PyroFourTwenty/SolarStation/3DModels/Sensorholder.stl

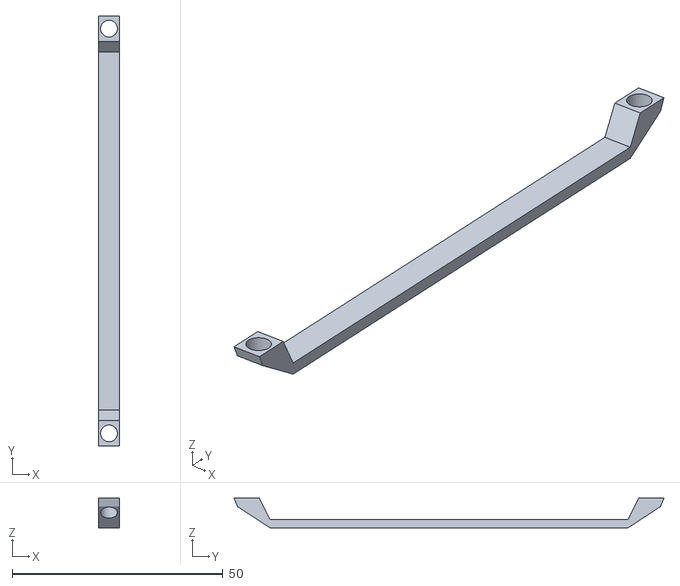
[picture p19: CAD file, 2020-07-06]
3DModels/Sensorholder.stl
5.00 x 102.0 x 7.00
