PyroFourTwenty/SolarStation/3DModels/RollerAngle.stl

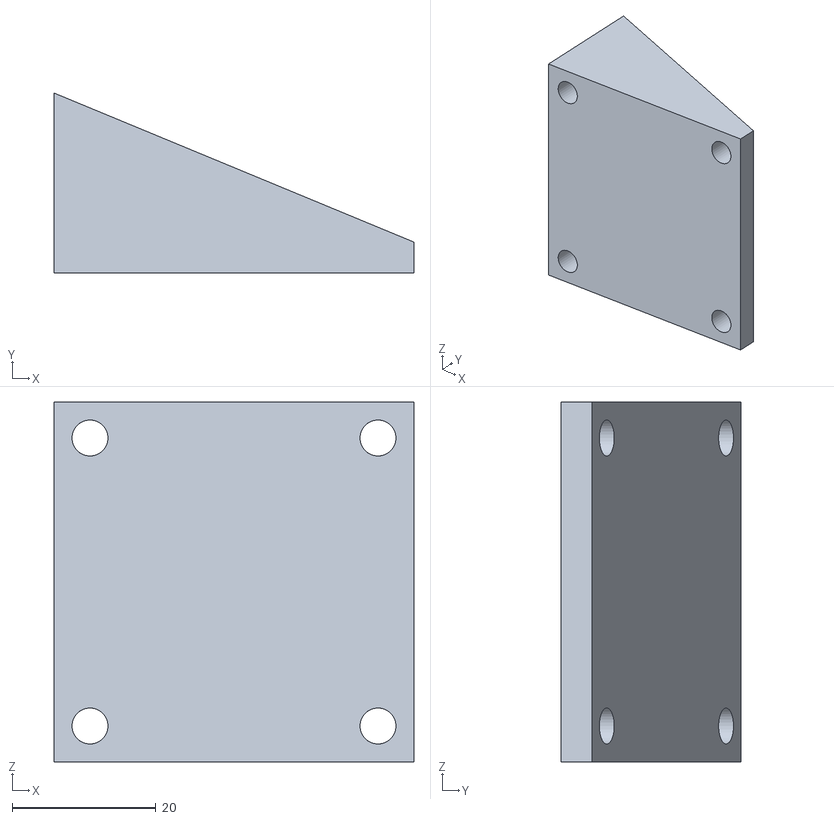
[picture p20: CAD file, 2020-07-06]
3DModels/RollerAngle.stl
50.0 x 25.0 x 50.0
