PyroFourTwenty/SolarStation/3DModels/MidAngle.stl

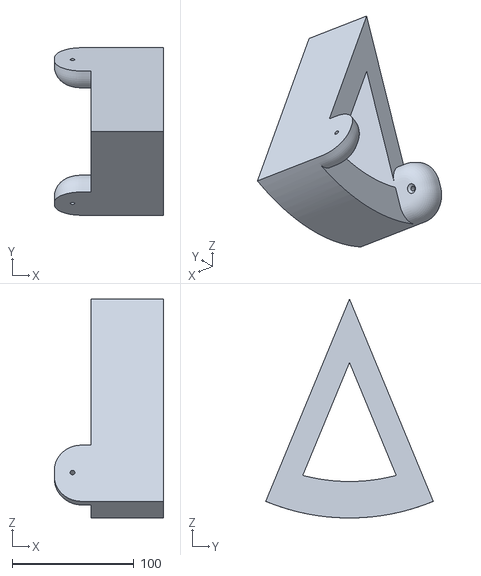
[picture p21: CAD file, 2020-07-06]
3DModels/MidAngle.stl
90.0 x 137.8 x 180.0
