PyroFourTwenty/SolarStation/(list of files, drawings)

Other design files:
Fritzing/Solarstation.fzz
