PyroFourTwenty/SolarStation/(commit log)

2020-07-06 final version
    [config.cfg]
2020-07-06 added 3D printable models
    [MidAngle.stl, RollerAngle.stl, Sensorholder.stl]
2020-07-24 added Fritzing file
    [Solarstation.fzz]
